ADOX-SA/Dispenser-de-jabon/(commit log)

2022-11-28 DispenserJabon
    Programa en arduino para el dispenser de jabón.
2022-11-28 Cuando presionamos el boton subir/bajar sube de a un litro. Y si lo mantenemos PRESIONADO va subiendo/bajando solo.
2022-11-29 Si se desconecta recuerda el último valor de litros usado.
2022-11-29 Si se desconecta mantiene el valor de litros usado.
2023-01-19 Ultima versión, con precisión de 0.01 segundos
